Dinesh123207/airsafe_rust_software/analysis-panel.png

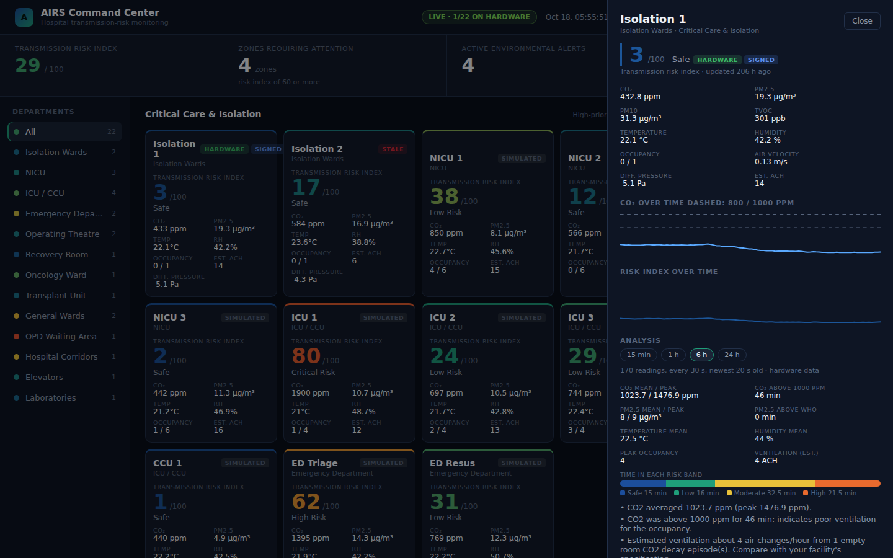
analysis-panel.png
